TheBrokenEngineer/Desktop-Thermometer/Hardware/PIC16F15214 Debugger/PIC16F15214 Debugger.pdf

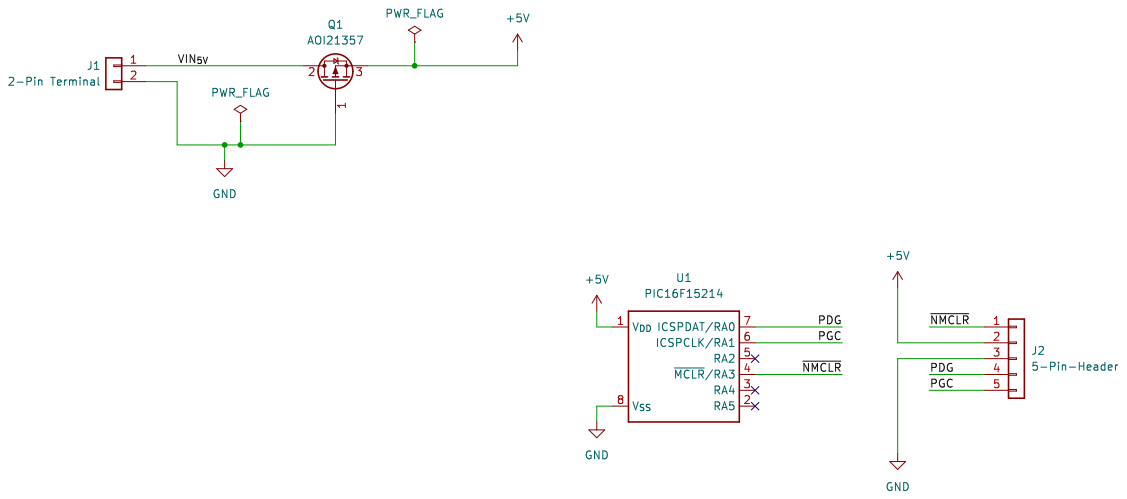
[picture p1: page 1]
