TheBrokenEngineer/Desktop-Thermometer/Hardware/Desktop Thermometer USB-2/Desktop Thermometer USB-2.pdf

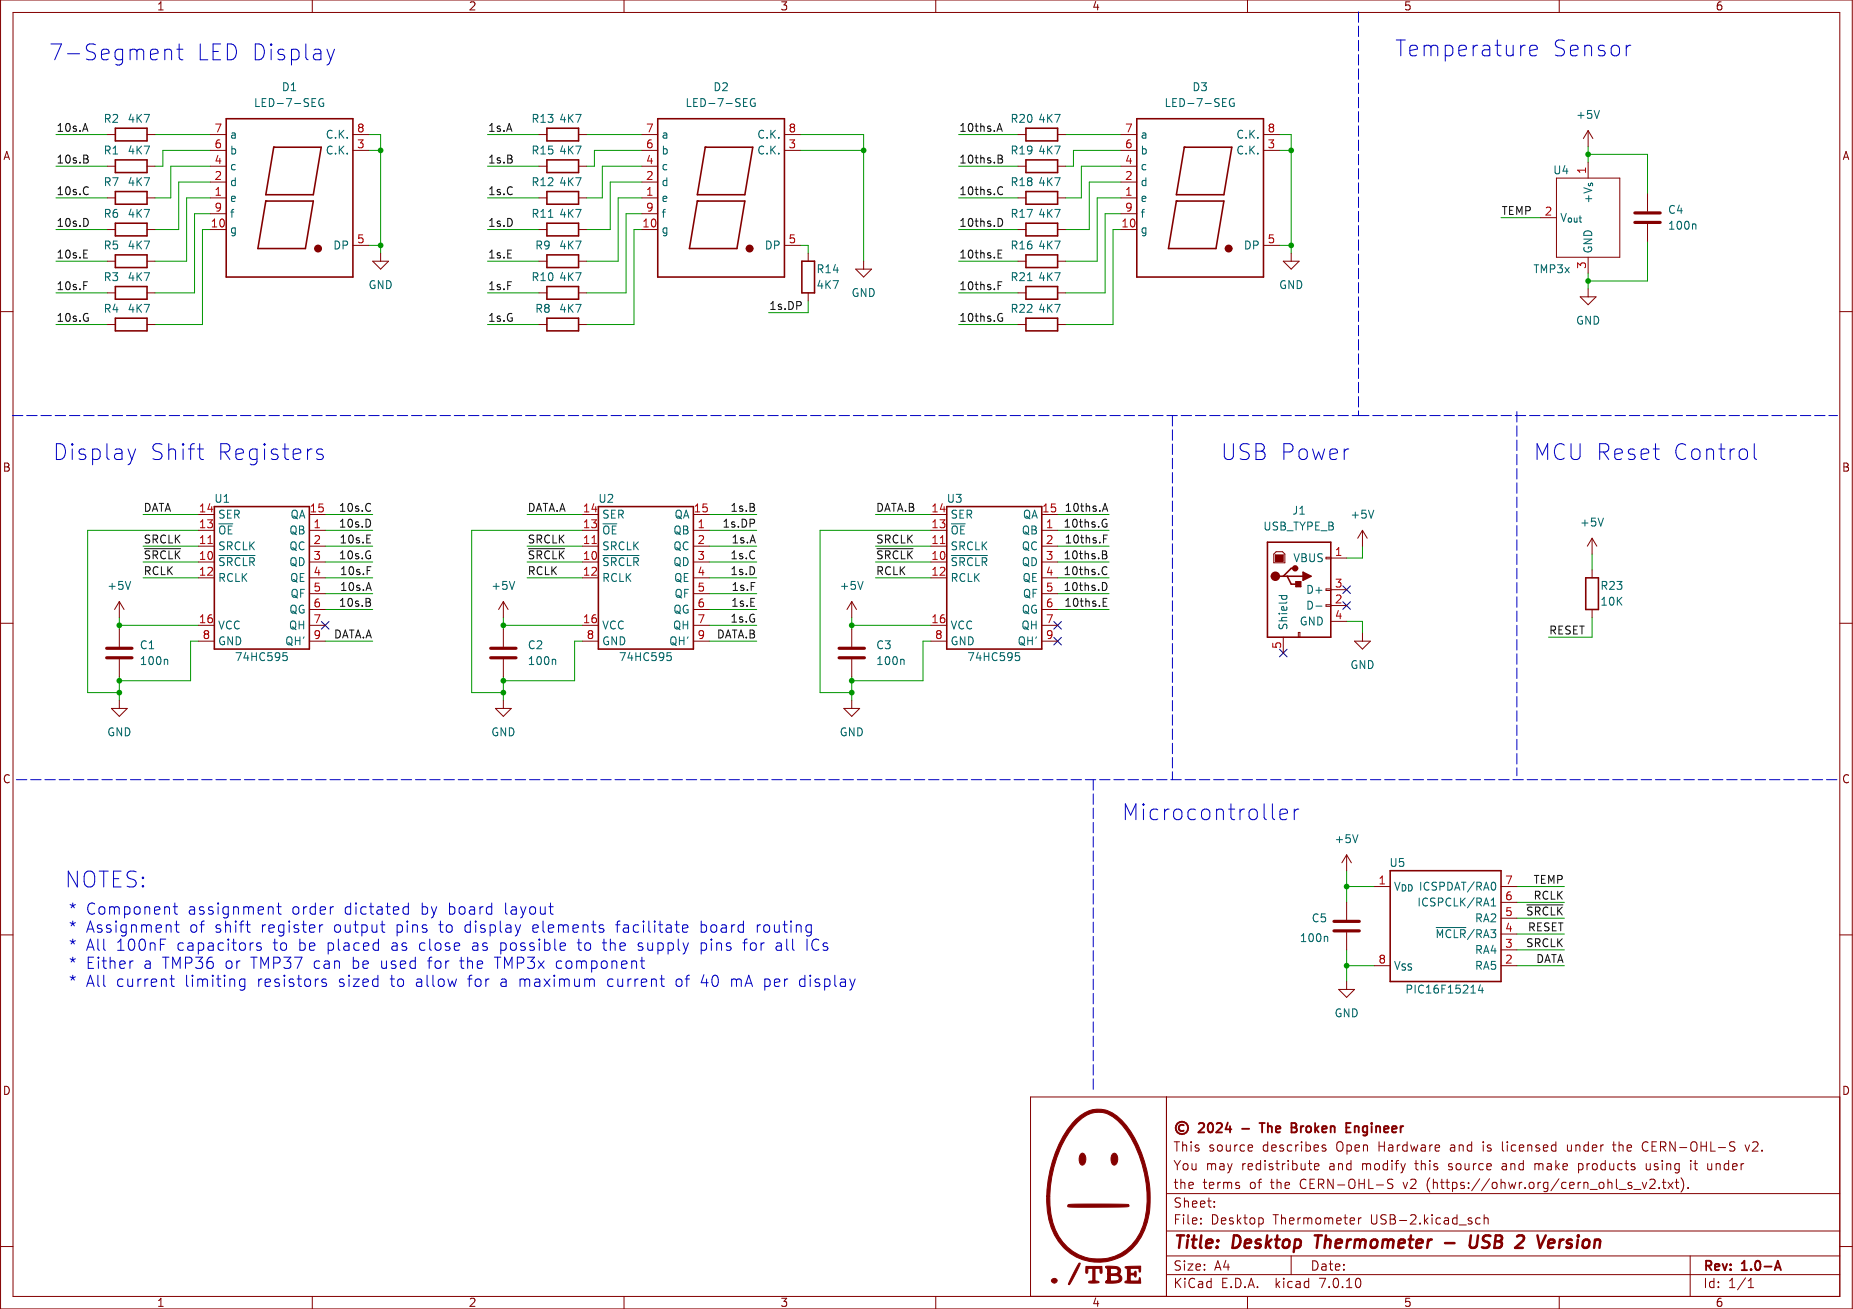
[picture p2: page 1]
