TheBrokenEngineer/Desktop-Thermometer/Hardware/Desktop Thermometer USB-C/Desktop Thermometer USB-C Version.pdf

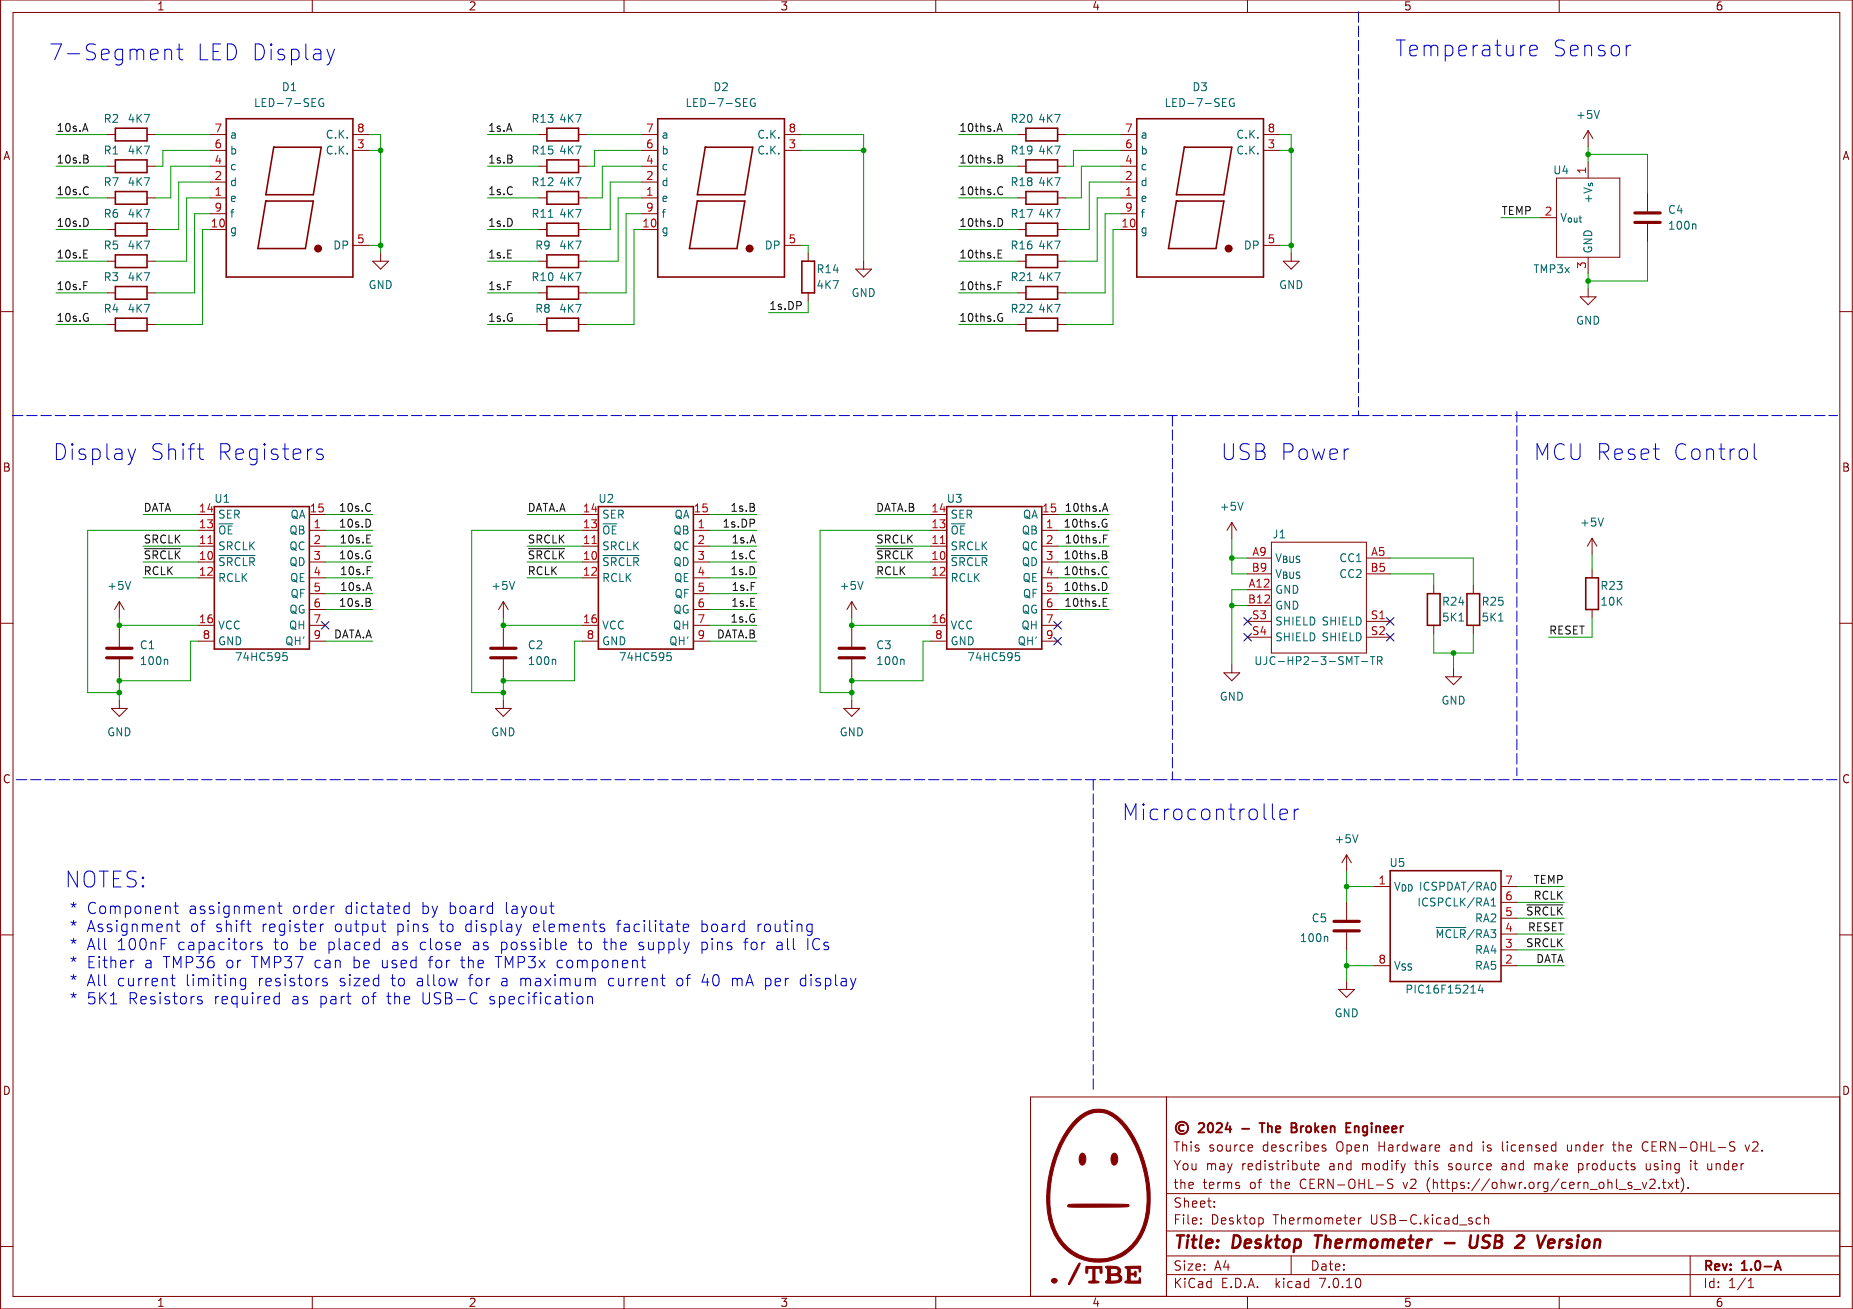
[picture p3: page 1]
