TheBrokenEngineer/Desktop-Thermometer/Hardware/PIC16F15214 Debugger/PIC16F15214 Debugger.kicad_pcb

## KiCad design Hardware/PIC16F15214 Debugger/PIC16F15214 Debugger.kicad_pcb (2024-02-27)

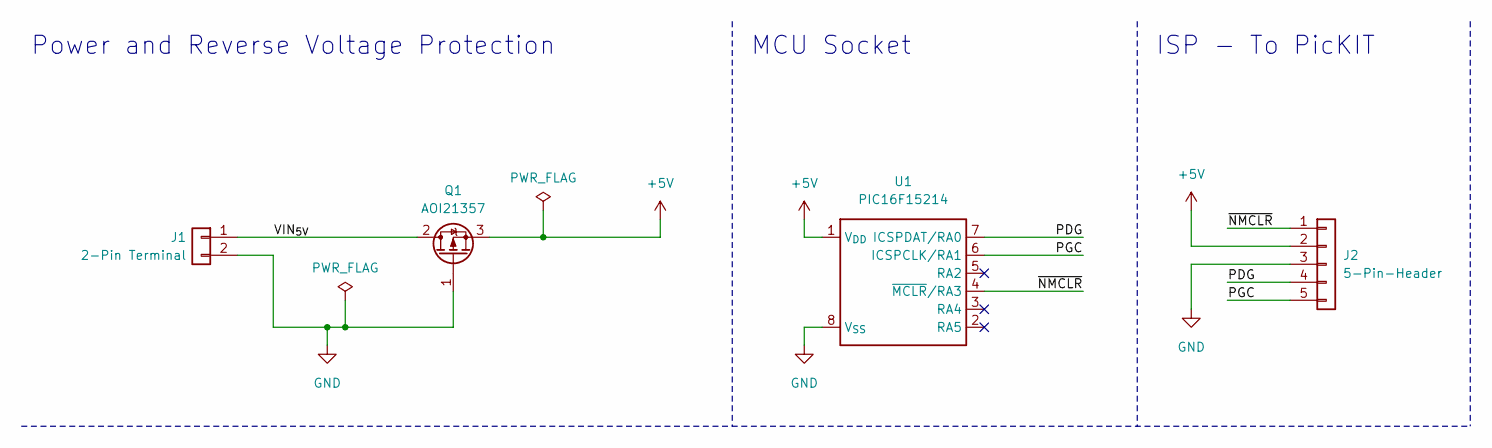
[picture p4: schematic PIC16F15214 Debugger.kicad_sch, PIC Program/Debug Adapter]

Parts:
J1: 2-Pin Terminal; Wurth 2 Pin Screwless Entry Wire to Board Connector
J2: 5-Pin-Header
Q1: AOI21357
U1: PIC16F15214; DIP-8_W7.62mm_Socket_Wire_Wrap

Connections:
+5V: J2.2, Q1.3 (S), U1.1 (V_{DD})
/PDG: J2.4, U1.7 (ICSPDAT/RA0)
/PGC: J2.5, U1.6 (ICSPCLK/RA1)
/VIN_{5V}: J1.1, Q1.2 (D)
/~NMCLR: J2.1, U1.4 (~MCLR/RA3)
GND: J1.2, J2.3, Q1.1 (G), U1.8 (V_{SS})

Notes on the sheet:
Power and Reverse Voltage Protection
ISP - To PicKIT
MCU Socket

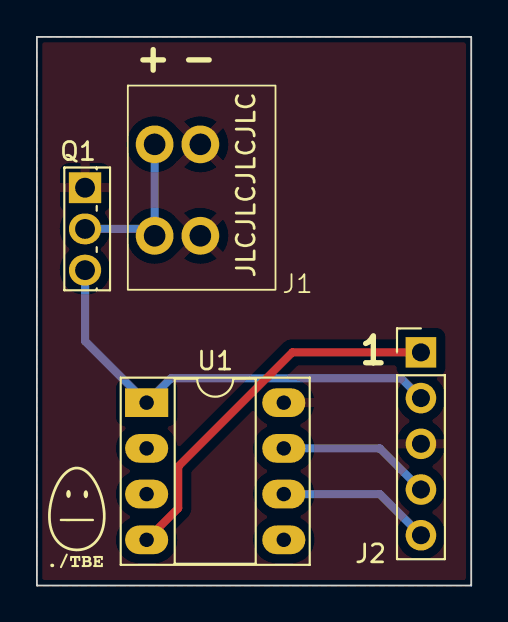
[picture p5: board PIC16F15214 Debugger.kicad_pcb from above]

Board: 2 copper layers, 24.1 x 30.5 mm, 4 parts (0 on the bottom side), 6 nets.
