TheBrokenEngineer/Desktop-Thermometer/(commit log)

2024-02-05 Created basic hardware schematic and models
    [Desktop Thermometer USB-2.kicad_pcb, Desktop Thermometer USB-2.kicad_sch]
2024-02-05 Updated some symbols and footprints. Also added a new model for an epoxy type ceramic capacitor
    [Desktop Thermometer USB-2.kicad_sch]
2024-02-05 Schematic roughed out, requires a tidy up into sections. Added some more symbols and footprints...Hopefully done with that stuff!
    [Desktop Thermometer USB-2.kicad_sch, Display.kicad_sch, MCU-Sensor-Power.kicad_sch]
2024-02-05 Initial attempt of PCB layout
    [Desktop Thermometer USB-2.kicad_pcb, Desktop Thermometer USB-2.kicad_sch]
2024-02-06 Traces added, still have some thermal relief issues that require investigation
    [Desktop Thermometer USB-2.kicad_pcb]
2024-02-06 Make the schematic pretty and create the USB-C variant of the hardware.
    [Desktop Thermometer USB-C.kicad_pcb, Desktop Thermometer USB-C.kicad_sch, Display.kicad_sch, MCU-Sensor-Power.kicad_sch]
2024-02-06 Updated the USB-C version of the schematic and updated the board to reflect changes
    [Desktop Thermometer USB-C.kicad_pcb, Desktop Thermometer USB-C.kicad_sch]
2024-02-06 Managed to get the footprint for the TMP3x device around the wrong way, this is now fixed. Also included data sheets for the PIC programmer and updates to the code configuration after testing.
    [Desktop Thermometer USB-2.kicad_pcb, Desktop Thermometer USB-C.kicad_pcb, Desktop Thermometer USB-C.kicad_sch]
2024-02-08 Finished PCB routing and generated GERBERS for both versions of the hardware.
    [Desktop Thermometer USB-2-B_Cu.gbl, Desktop Thermometer USB-2-B_Cu.gbr, Desktop Thermometer USB-2-B_Mask.gbr, Desktop Thermometer USB-2-B_Mask.gbs, Desktop Thermometer USB-2-B_Paste.gbp, Desktop Thermometer USB-2-B_Paste.gbr, Desktop Thermometer USB-2-B_Silkscreen.gbo, Desktop Thermometer USB-2-B_Silkscreen.gbr]
2024-02-09 Created the debugger/programmer. Also generated the PCB gerber files for submission to the FAB house
    [Desktop Thermometer USB-2-B_Cu.gbl, Desktop Thermometer USB-2-B_Cu.gbr, Desktop Thermometer USB-2-B_Mask.gbr, Desktop Thermometer USB-2-B_Mask.gbs, Desktop Thermometer USB-2-B_Paste.gbp, Desktop Thermometer USB-2-B_Silkscreen.gbo, Desktop Thermometer USB-2-B_Silkscreen.gbr, Desktop Thermometer USB-2-Edge_Cuts.gm1]
2024-02-15 Created PDF versions of the schematic diagrams
2024-02-27 Final Version, project finished
    [Desktop Thermometer USB-2.kicad_pcb, Desktop Thermometer USB-2.kicad_sch, Desktop Thermometer USB-C.kicad_pcb, Desktop Thermometer USB-C.kicad_sch, PIC16F15214 Debugger.kicad_pcb, PIC16F15214 Debugger.kicad_sch]
