TheBrokenEngineer/Desktop-Thermometer/(notices)

Notices in the files:
Firmware/main.c:
This program is free software: you can redistribute it and/or modify
it under the terms of the GNU General Public License as published by
the Free Software Foundation, either version 3 of the License, or
(at your option) any later version.
Hardware/Desktop Thermometer USB-2/Desktop Thermometer USB-2.kicad_pcb:
Copyright © 2024 - The Broken Engineer
Licensed under CERN-OHL-2 v2
